benjaminbellamy/Deodshiot/Images/Deodshiot_schem.pdf

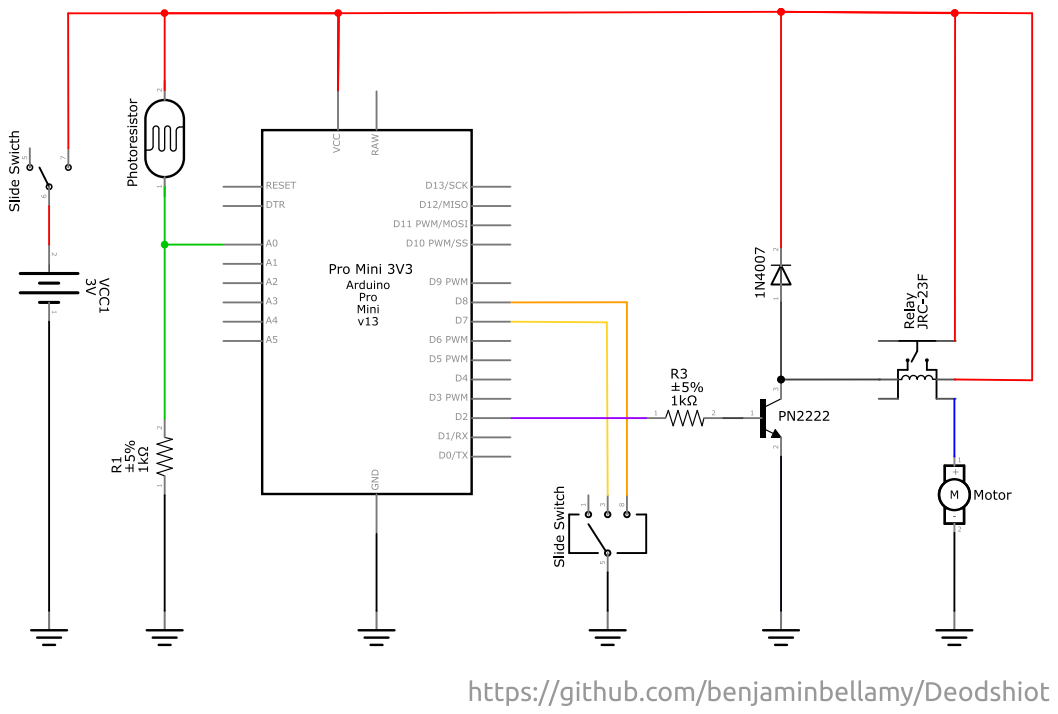
[picture p16: page 1]
