benjaminbellamy/Deodshiot/(commit log)

2020-03-23 First Arduino commit
2020-03-23 Added schematic
2020-03-26 Updated schematic, added pdf
2020-04-04 Added bakelite schematic
2020-04-04 Added 2nd bakelite schematic
2020-04-04 Added IOT schematic
2020-04-05 Added beautiful Pictures…
